DanNixon/Iku/README.md

Iku
===

A kit that converts a standard ATX PS2 power suppy into a bench power supply.
