DanNixon/Iku/Parts.md

Parts
=====

List of parts that can be purchased from Mouser:

- [ATX power connector (Molex)](http://uk.mouser.com/ProductDetail/Molex/39-28-1243/?qs=%2fha2pyFaduiekFMjQBd2HDC1BZn0GyJcyX4eSxCKYSs%3d)
- [Screw terminals](http://uk.mouser.com/ProductDetail/Pomona-Electronics/6883/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)
- [Channel switches](http://uk.mouser.com/ProductDetail/NKK-Switches/CWSB11AA2F/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)
- [Main switch](http://uk.mouser.com/ProductDetail/NKK-Switches/M2033TNW01-EA/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)
- [Relays](http://uk.mouser.com/ProductDetail/Panasonic/ALF1P05/?qs=%2fha2pyFadugQgyR4Ae26P8gLqDGQtkRgd3hi3bIP0RU%3d)
- [Spade terminals (Molex)](http://uk.mouser.com/ProductDetail/Molex/19705-4001/?qs=sGAEpiMZZMvz8LftK4jers568XOTYzlN4NL4EWmf%2fY4%3d)
- [1N4007](http://uk.mouser.com/ProductDetail/Fairchild-Semiconductor/1N4007/?qs=sGAEpiMZZMuQUXCJI7Y4lvWy%252b1U8RtCq)
- [2N3906](http://uk.mouser.com/ProductDetail/Central-Semiconductor/2N3906/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)
