DanNixon/Iku/cad/BackPanel.dxf

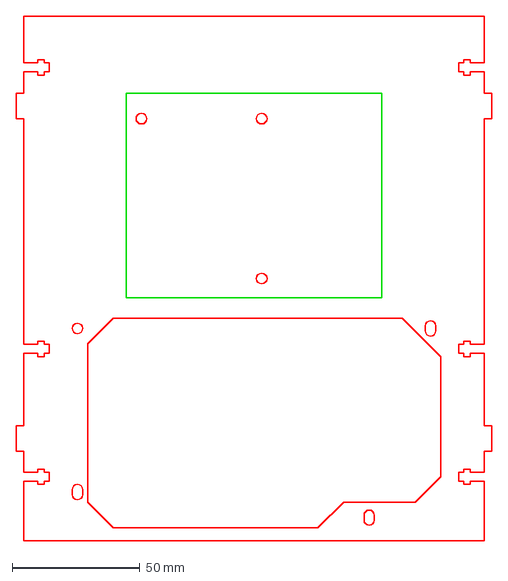
[picture p1: CAD file, 2015-04-20]
cad/BackPanel.dxf
186.0 x 205.0 mm
