DanNixon/Iku/cad/FrontAngledPanel.dxf

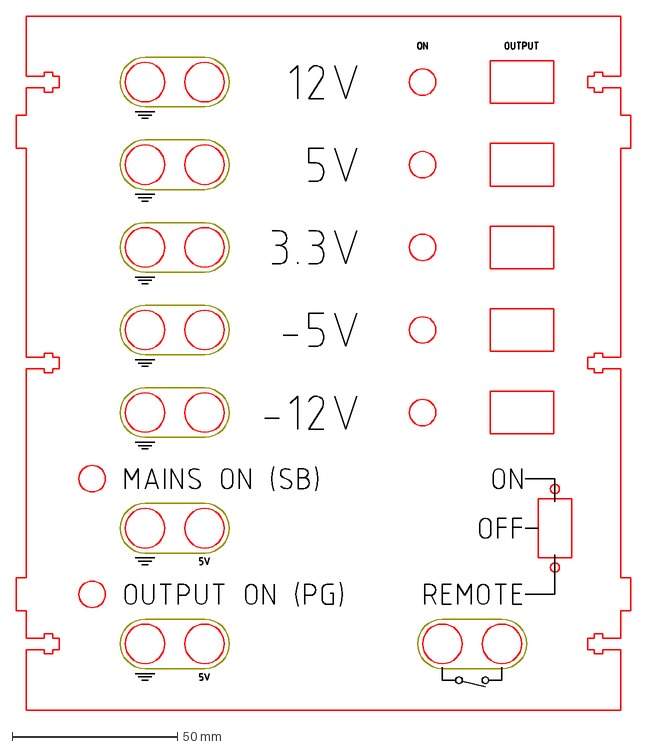
[picture p2: CAD file, 2015-04-18]
cad/FrontAngledPanel.dxf
186.0 x 210.0 mm
