DanNixon/Iku/cad/FrontPanel.dxf

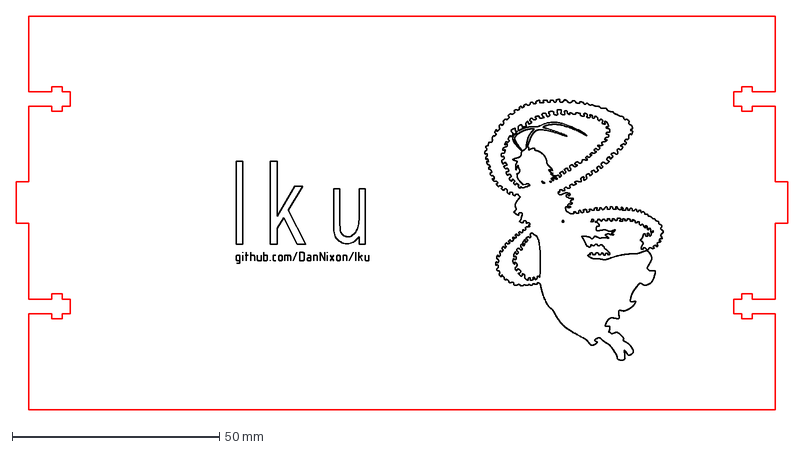
[picture p3: CAD file, 2015-04-18]
cad/FrontPanel.dxf
186.0 x 95.0 mm
