DanNixon/Iku/cad/BottomPanel.dxf

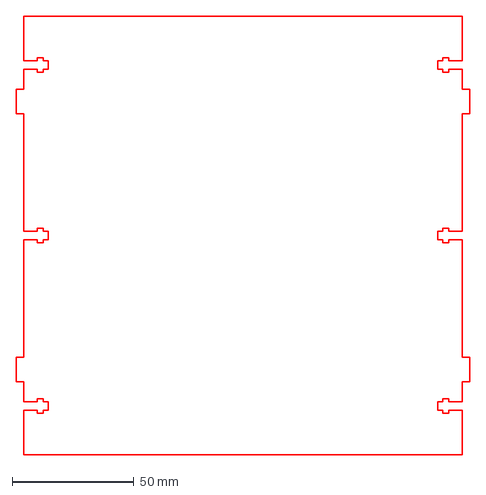
[picture p4: CAD file, 2015-03-12]
cad/BottomPanel.dxf
186.0 x 180.0 mm
