DanNixon/Iku/cad/SidePanel.dxf

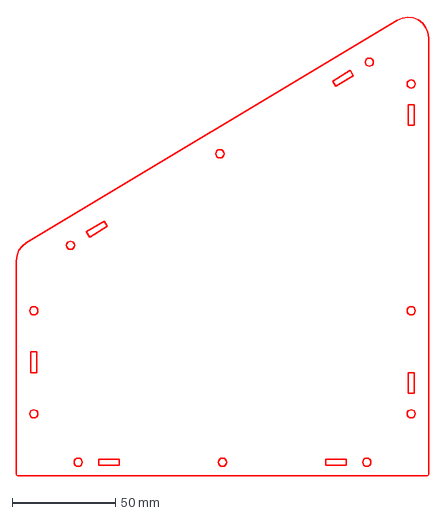
[picture p5: CAD file, 2015-03-12]
cad/SidePanel.dxf
200.0 x 222.8 mm
