DanNixon/Iku/Eagle/SwitchedATXBreakout.brd

## EAGLE design Eagle/SwitchedATXBreakout.brd (2015-04-18)

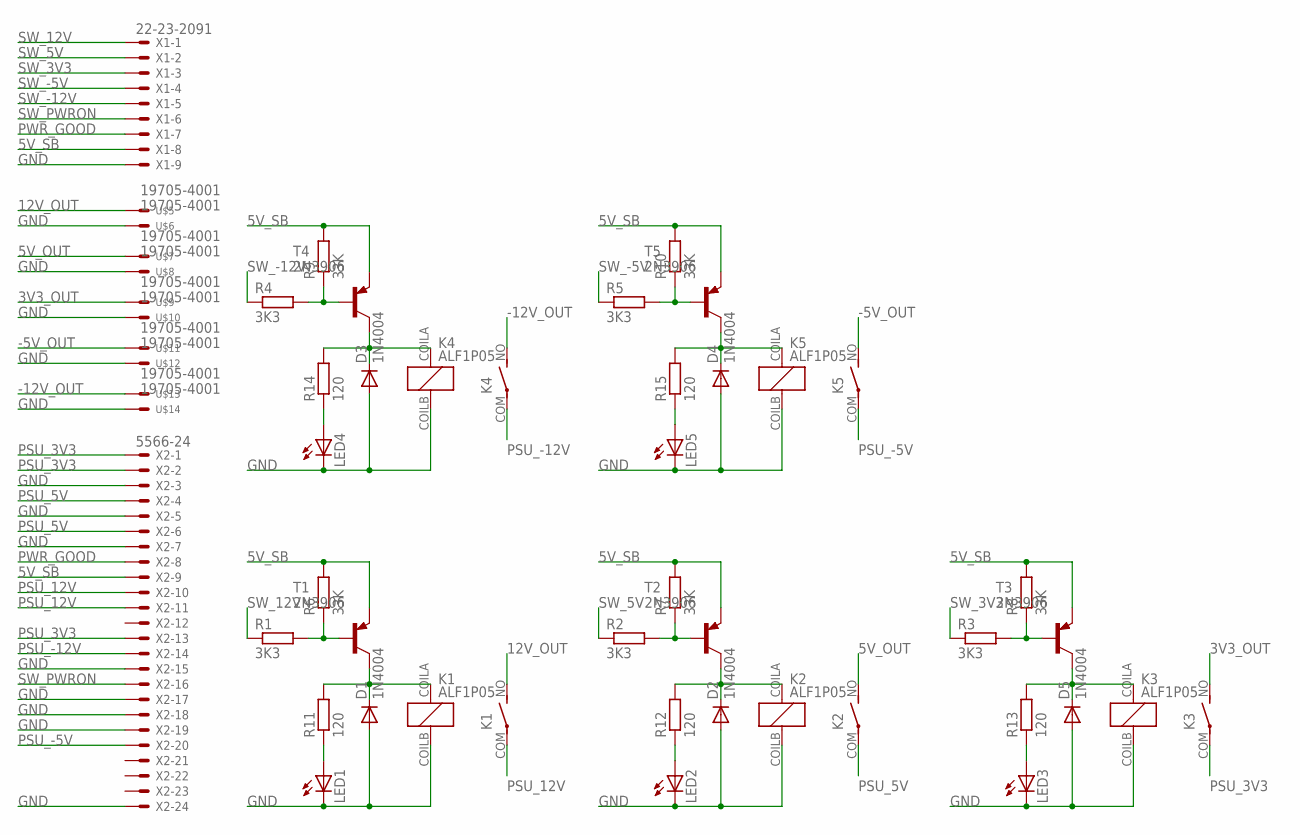
[picture p6: schematic SwitchedATXBreakout.sch]

Parts:
D1, D2, D3, D4, D5: 1N4004; DO41-10
K1, K2, K3, K4, K5: ALF1P05; ALF
LED1, LED2, LED3, LED4, LED5: LED3MM
R1, R2, R3, R4, R5: 3K3; 0204/7
R6, R7, R8, R9, R10: 33K; 0204/7
R11, R12, R13, R14, R15: 120; 0204/7
T1, T2, T3, T4, T5: 2N3906; TO92-EBC
U$5, U$6, U$7, U$8, U$9, U$10, U$11, U$12, U$13, U$14: 19705-4001
X1: 22-23-2091
X2: 5566-24

Connections:
3V3_OUT: K3.NO (S), U$9.P$1, U$9.P$2
5V_OUT: K2.NO (S), U$7.P$1, U$7.P$2
5V_SB: R6.2, R7.2, R8.2, R9.2, R10.2, T1.E, T2.E, T3.E, T4.E, T5.E, X1.8, X2.9
12V_OUT: K1.NO (S), U$5.P$1, U$5.P$2
-5V_OUT: K5.NO (S), U$11.P$1, U$11.P$2
-12V_OUT: K4.NO (S), U$13.P$1, U$13.P$2
GND: D1.A, D2.A, D3.A, D4.A, D5.A, K1.COILB (2), K2.COILB (2), K3.COILB (2), K4.COILB (2), K5.COILB (2), LED1.K (C), LED2.K (C), LED3.K (C), LED4.K (C), LED5.K (C), U$6.P$1, U$6.P$2, U$8.P$1, U$8.P$2, U$10.P$1, U$10.P$2, U$12.P$1, U$12.P$2, U$14.P$1, U$14.P$2, X1.9, X2.3, X2.5, X2.7, X2.15, X2.17, X2.18, X2.19, X2.24
unnamed: R1.2, R6.1, T1.B
unnamed: R4.2, R9.1, T4.B
unnamed: D1.C, K1.COILA (1), R11.2, T1.C
unnamed: D2.C, K2.COILA (1), R12.2, T2.C
unnamed: R5.2, R10.1, T5.B
unnamed: R2.2, R7.1, T2.B
unnamed: R3.2, R8.1, T3.B
unnamed: D3.C, K4.COILA (1), R14.2, T4.C
unnamed: LED1.A, R11.1
unnamed: LED2.A, R12.1
unnamed: D4.C, K5.COILA (1), R15.2, T5.C
unnamed: LED3.A, R13.1
unnamed: LED5.A, R15.1
unnamed: D5.C, K3.COILA (1), R13.2, T3.C
unnamed: LED4.A, R14.1
PSU_3V3: K3.COM, X2.1, X2.2, X2.13
PSU_5V: K2.COM, X2.4, X2.6
PSU_12V: K1.COM, X2.10, X2.11
PSU_-5V: K5.COM, X2.20
PSU_-12V: K4.COM, X2.14
PWR_GOOD: X1.7, X2.8
SW_3V3: R3.1, X1.3
SW_5V: R2.1, X1.2
SW_12V: R1.1, X1.1
SW_-5V: R5.1, X1.4
SW_-12V: R4.1, X1.5
SW_PWRON: X1.6, X2.16

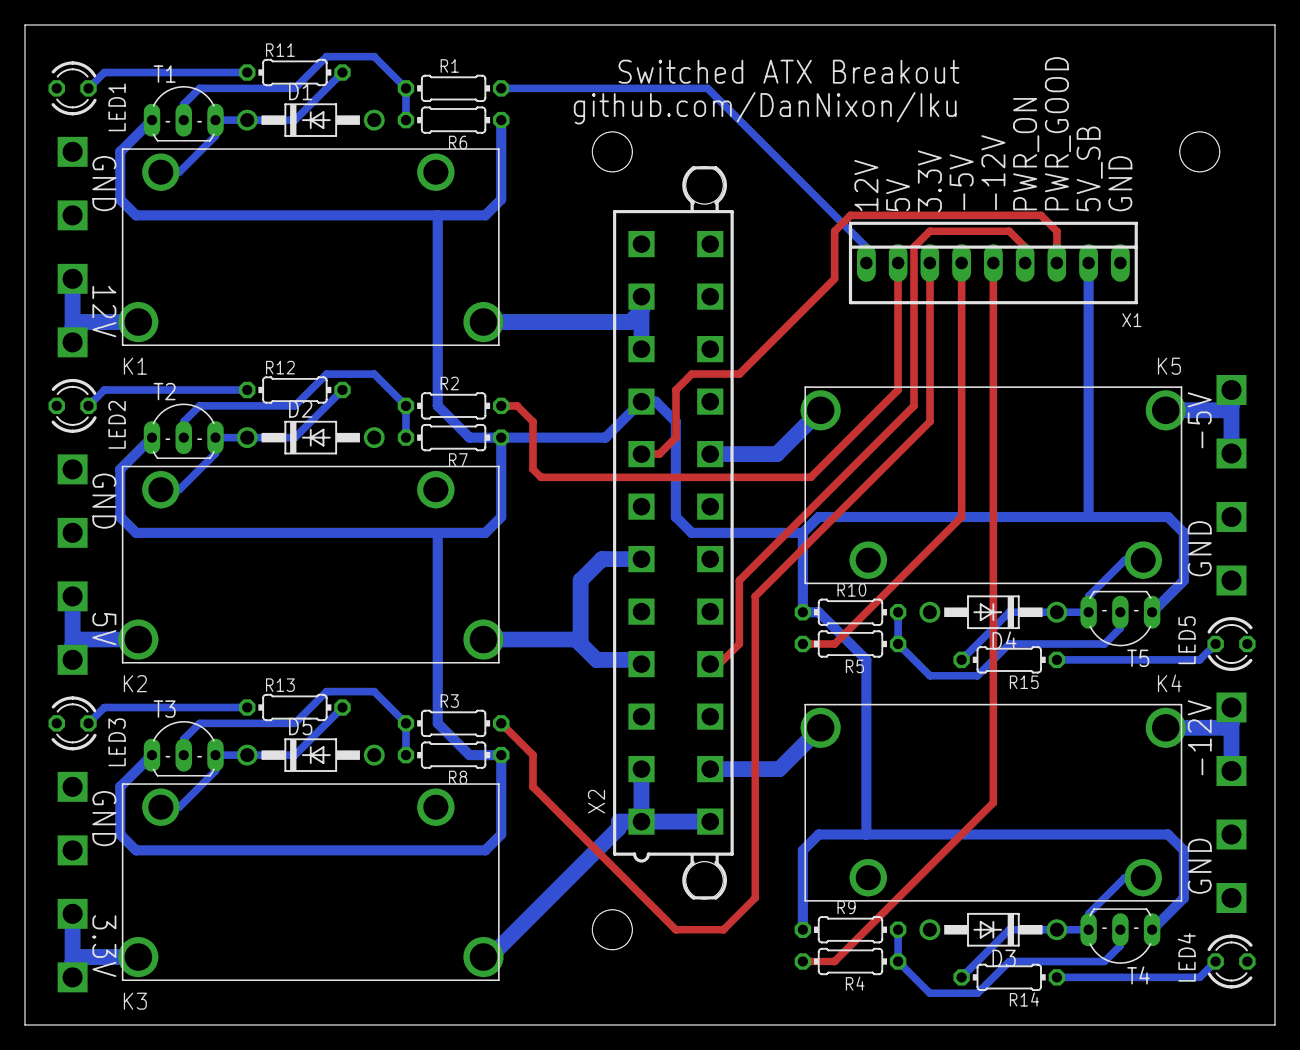
[picture p7: board SwitchedATXBreakout.brd from above]

Board: 2 copper layers, 100.0 x 80.0 mm, 47 parts (0 on the bottom side), 34 nets.
