DanNixon/Iku/(commit log)

2015-03-12 Initial CAD files
    [BackPanel.dxf, BottomPanel.dxf, FrontPanel.dxf, SidePanel.dxf]
2015-03-12 Added front panel
    [FrontAngledPanel.dxf]
2015-03-12 Updates, added tabs
    [BackPanel.dxf, BottomPanel.dxf, FrontAngledPanel.dxf, FrontPanel.dxf, SidePanel.dxf]
2015-03-12 Lay out front panel
    [FrontAngledPanel.dxf]
2015-03-14 Minor fixes for front panel
    [FrontAngledPanel.dxf]
2015-03-16 Added EAGLE project
    [SwitchedATXBreakout.sch]
2015-03-24 Update Eagle drawings
    [SwitchedATXBreakout.sch]
2015-03-24 More work on board
    [SwitchedATXBreakout.sch]
2015-03-26 Finish schematic
    [SwitchedATXBreakout.sch]
2015-03-28 Start board layout
    [SwitchedATXBreakout.brd, SwitchedATXBreakout.sch]
2015-03-29 Finish board layout
    [SwitchedATXBreakout.brd, SwitchedATXBreakout.sch]
2015-04-04 Updated board layout
    [SwitchedATXBreakout.brd, SwitchedATXBreakout.sch]
2015-04-07 Fixed some placement errors
    [SwitchedATXBreakout.brd]
2015-04-10 Add switched ATX breakout to back panel
    [BackPanel.dxf]
2015-04-18 Small updates
    [SwitchedATXBreakout.brd, SwitchedATXBreakout.sch]
2015-04-18 Update CAD
    [FrontAngledPanel.dxf, FrontPanel.dxf]
2015-04-20 CAD update
    [BackPanel.dxf]
2015-04-20 Move board
    [BackPanel.dxf]
